stephennacion06/power-theft-detection/3D File/Rendered/Iso_prototype.jpg

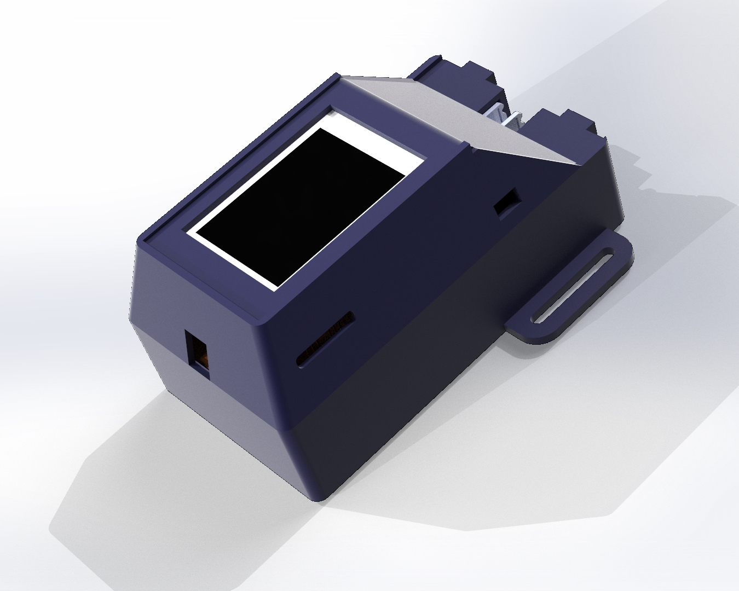
3D File/Rendered/Iso_prototype.jpg
