stephennacion06/power-theft-detection/3D File/Rendered/iso_back.jpg

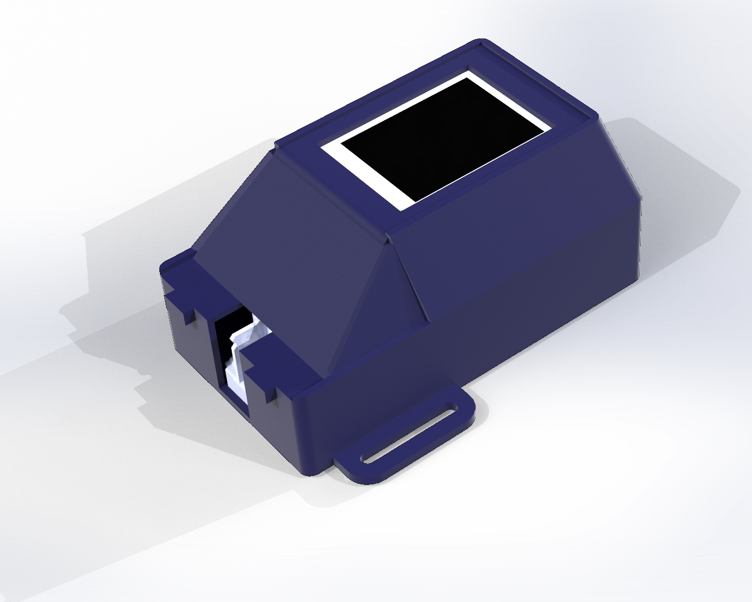
3D File/Rendered/iso_back.jpg
