stephennacion06/power-theft-detection/README.md

# power-theft-detection
Official Repository for Power Theft Detection System Project
