stephennacion06/power-theft-detection/3D File/3D printing/version_main_chassis_hours.PNG

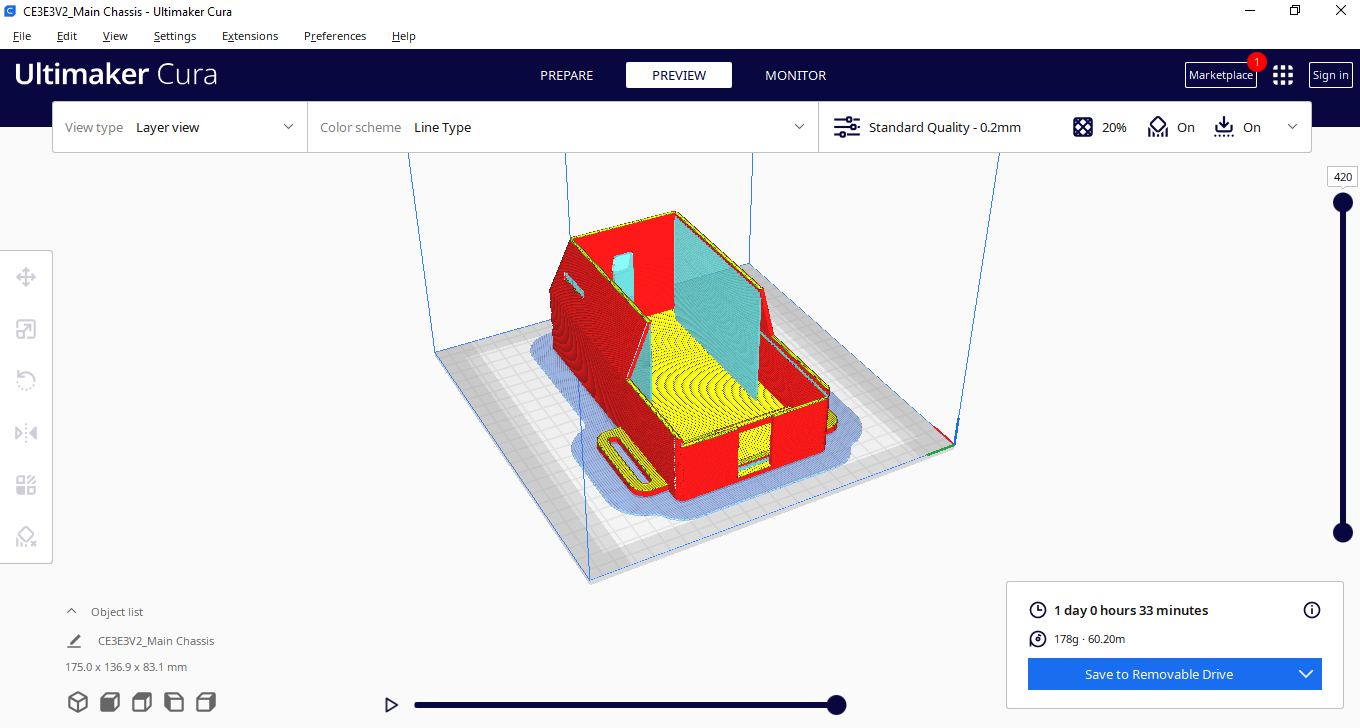
3D File/3D printing/version_main_chassis_hours.PNG
