stephennacion06/power-theft-detection/3D File/Rendered/glass_iso.jpg

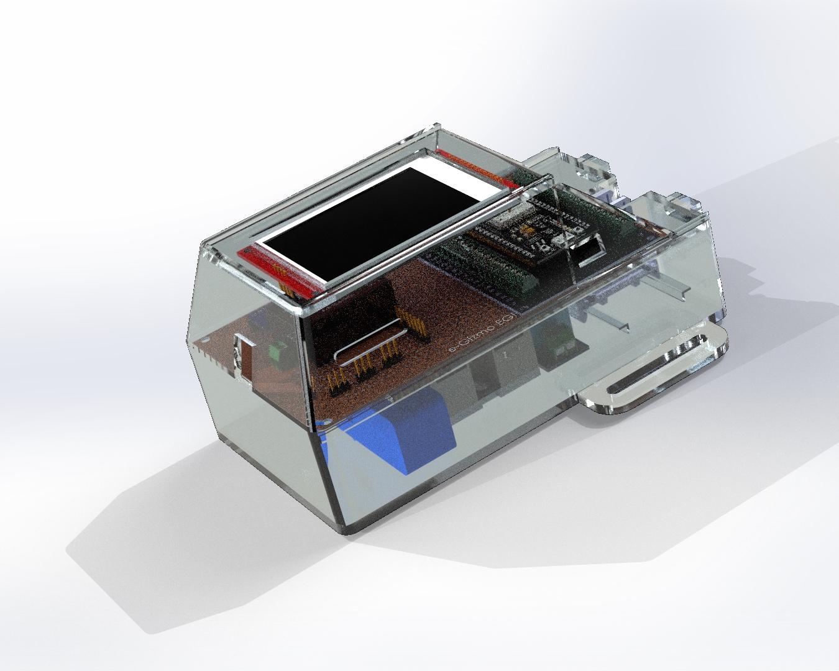
3D File/Rendered/glass_iso.jpg
