stephennacion06/power-theft-detection/3D File/Rendered/glass_rendered_back.jpg

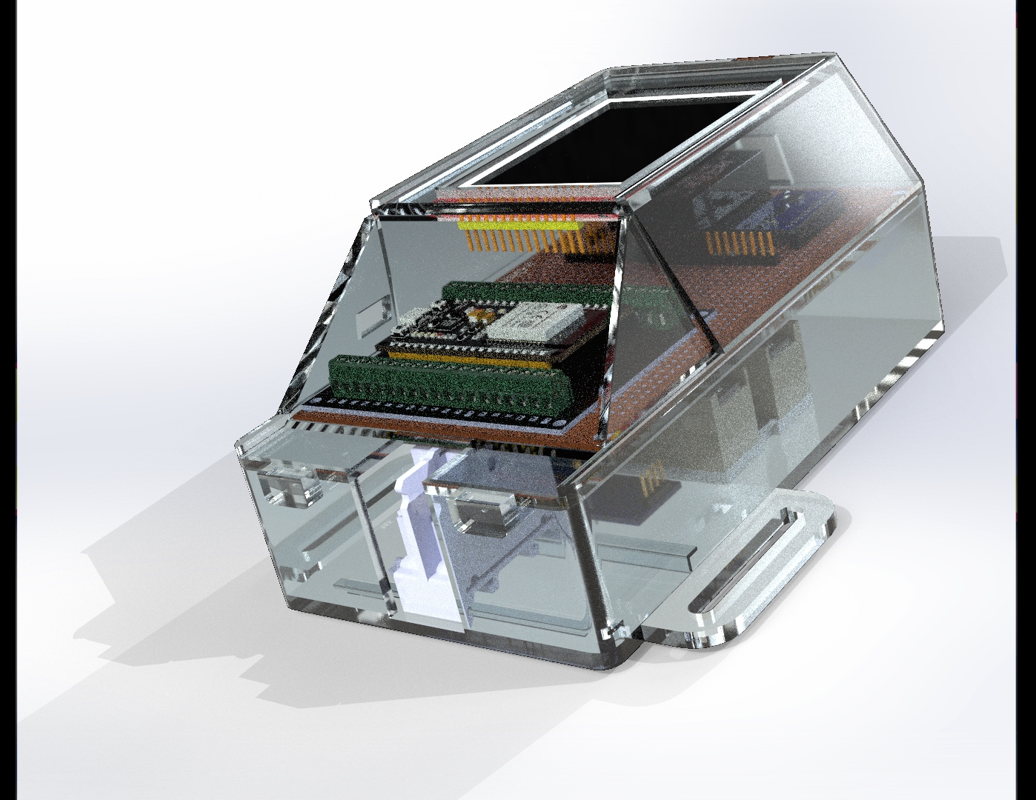
3D File/Rendered/glass_rendered_back.jpg
