stephennacion06/power-theft-detection/Documents/Design Docs/BoM.PNG

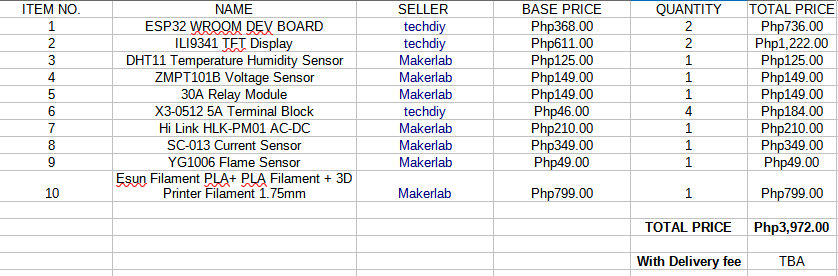
Documents/Design Docs/BoM.PNG
