stephennacion06/power-theft-detection/Documents/Design Docs/flow_chart_diagram.png

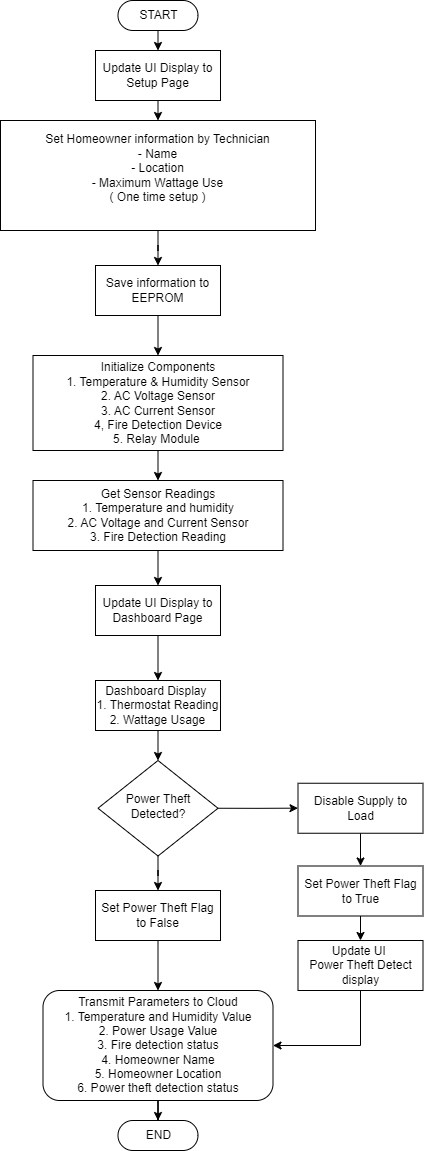
Documents/Design Docs/flow_chart_diagram.png
