stephennacion06/power-theft-detection/Documents/Design Docs/system_architecture_draft.png

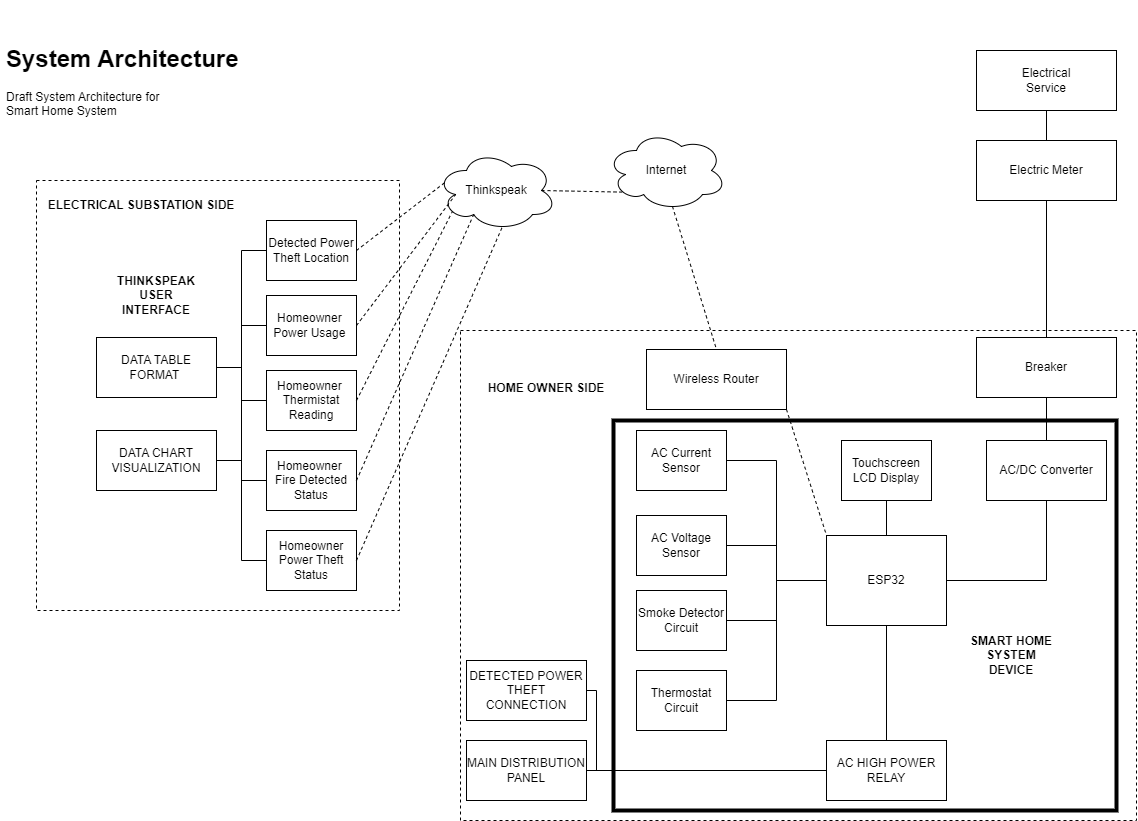
Documents/Design Docs/system_architecture_draft.png
