stephennacion06/power-theft-detection/Documents/References/design_button_1.PNG

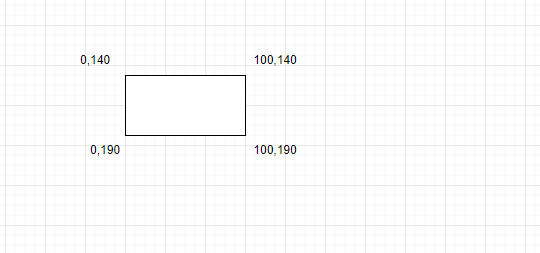
Documents/References/design_button_1.PNG
