stephennacion06/power-theft-detection/Documents/Design Docs/bill_of_materials.xlsx

ITEM NO. | NAME | SELLER | BASE PRICE | QUANTITY | TOTAL PRICE
1 | ESP32 WROOM DEV BOARD | techdiy (https://shopee.ph/38Pins-ESP32S-ESP32-2.4GHz-Dual-Core-WLAN-WiFi-Bluetooth-Microcontroller-ESP-WROOM-32-Chip-with-Breakout-Board-for-Arduino-i.306592453.21062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) | Php 368.00 | 1 | Php 368.00
2 | ILI9341 TFT Display | techdiy (https://shopee.ph/SPI-Serial-Port-Seriesctouch-2.2-2.4-2.8-3.2-3.5-4.0-Inch-TFT-LCD-Screen-Module-for-Stm32-Development-Board-i.306592453.22200907097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) | Php 611.00 | 1 | Php 611.00
3 | ZMPT101B Voltage Sensor | Makerlab (https://shopee.ph/AC-Voltage-Sensor-Module-ZMPT101B-i.18252381.6200885788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) | Php 149.00 | 1 | Php 149.00
4 | 30A Relay Module | Makerlab (https://shopee.ph/Taiwan-SSR-40DA-SSR-60DA-SSR-100DA-SSR-Solid-State-Relay-Module-i.18252381.190150070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) | Php 409.00 | 1 | Php 409.00
5 | X3-0512 5A Terminal Block | techdiy (https://shopee.ph/X3-2012-Nylon-Plastic-Terminal-Block-0512-1012-3012-6012-Connector-Copper-12-bit-20A-i.306592453.18611494771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) | Php 46.00 | 4 | Php 184.00
6 | Hi Link HLK-PM01 AC-DC | Makerlab (https://shopee.ph/Hi-Link-HLK-PM01-AC-DC-220V-to-5V-Step-down-Power-Supply-Module-i.18252381.1885503201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) | Php 210.00 | 1 | Php 210.00
7 | SC-013 Current Sensor | Makerlab (https://shopee.ph/Non-invasive-AC-Current-Sensor-30A-100A-SCT-013-030-i.18252381.242334790) | Php 349.00 | 1 | Php 349.00
8 | YG1006 Flame Sensor | Makerlab (https://shopee.ph/Flame-Sensor-Module-for-Arduino-i.18252381.314229553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) | Php 49.00 | 1 | Php 49.00
9 | Esun Filament PLA+ PLA Filament + 3D Printer Filament 1.75mm | Makerlab (https://shopee.ph/Esun-Filament-PLA-PLA-Filament-3D-Printer-Filament-1.75mm-i.18252381.1089934382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) | Php 799.00 | 1 | Php 799.00
10 | KY-021 Mini Dry Reed Switch Pipe Module | Makerlab (https://shopee.ph/KY-021-Mini-Dry-Reed-Switch-Pipe-Module-i.18252381.21906994555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) | Php 29.00 | 1 | Php 29.00
11 | PIR Motion Sensor SR501 HC-SR501 Module for Arduino Raspberry Pi | Makerlab (https://shopee.ph/PIR-Motion-Sensor-SR501-HC-SR501-Module-for-Arduino-Raspberry-Pi-i.18252381.190149793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) | Php 79.00 | 1 | Php 79.00
 |  |  |  | TOTAL PRICE | Php 3236.00
 |  |  |  | With Delivery fee | TBA
