stephennacion06/power-theft-detection/Documents/Design Docs/software_components.png

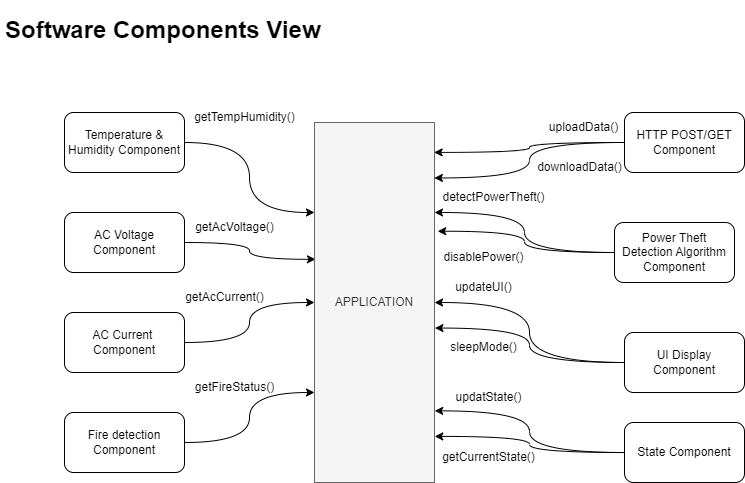
Documents/Design Docs/software_components.png
