stephennacion06/power-theft-detection/3D File/3D printing/Cover Main.STL

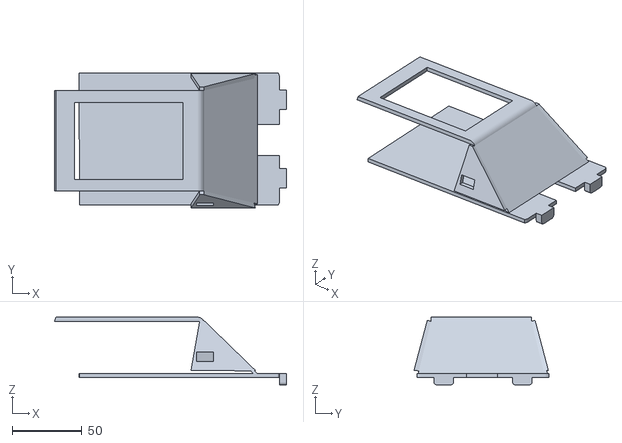
[picture p21: CAD file, 2023-07-22]
3D File/3D printing/Cover Main.STL
166.1 x 96.7 x 48.5
