stephennacion06/power-theft-detection/3D File/3D printing/Main Chassis.STL

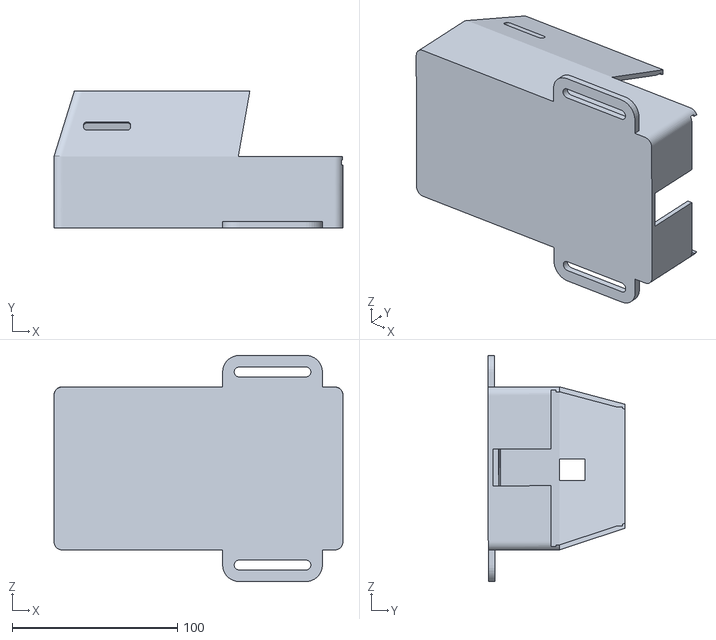
[picture p22: CAD file, 2023-07-22]
3D File/3D printing/Main Chassis.STL
175.0 x 83.2 x 136.9
