stephennacion06/power-theft-detection/3D File/Components/ky-021_door_sensor/male_header_angled.SLDASM

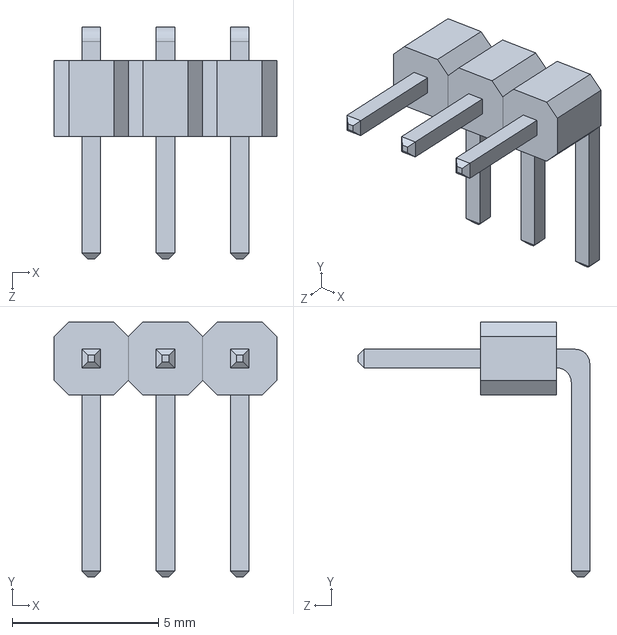
[picture p23: CAD file, 2023-07-19]
3D File/Components/ky-021_door_sensor/male_header_angled.SLDASM
7.62 x 8.73 x 7.94 mm
HeaderMalePart x 3
