stephennacion06/power-theft-detection/3D File/Components/pir-hc-sr-501/pir_hc_sr-501_sensor.SLDASM

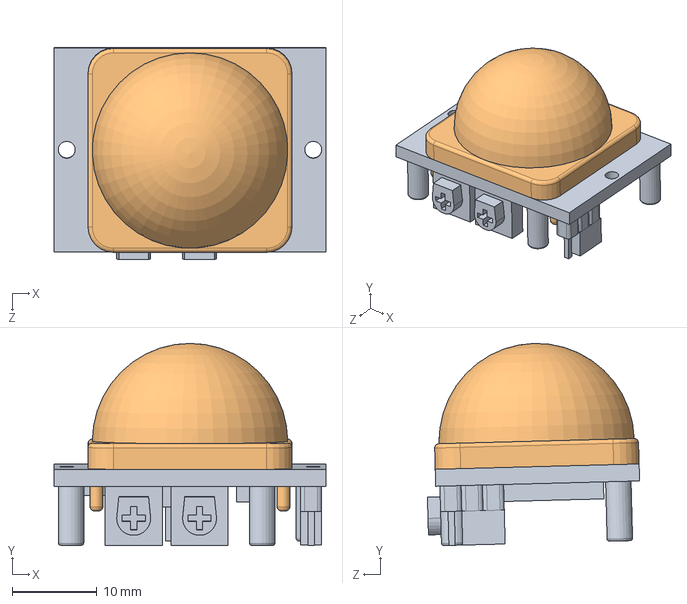
[picture p24: CAD file, 2023-07-19]
3D File/Components/pir-hc-sr-501/pir_hc_sr-501_sensor.SLDASM
32.0 x 23.8 x 25.0 mm
sensor
lens
