stephennacion06/power-theft-detection/3D File/Components/ky-021_door_sensor/ky-021.SLDASM

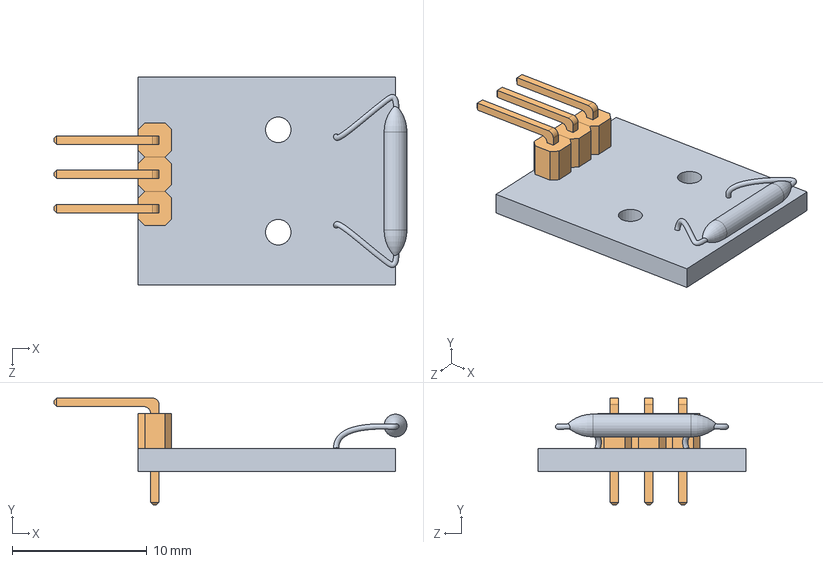
[picture p25: CAD file, 2023-07-19]
3D File/Components/ky-021_door_sensor/ky-021.SLDASM
26.2 x 7.94 x 15.4 mm
reed_switch_body
HeaderMalePart x 3
