stephennacion06/power-theft-detection/3D File/Components/current_sensor_sc103.SLDASM

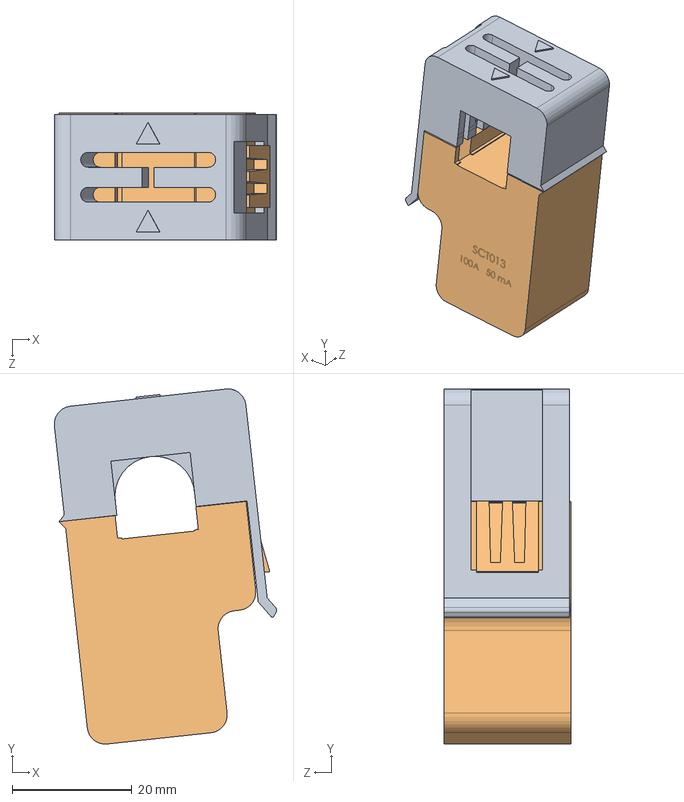
[picture p26: CAD file, 2023-07-19]
3D File/Components/current_sensor_sc103.SLDASM
37.1 x 59.3 x 21.3 mm
sensor part 1
sEnsor 2SLDPRT
