stephennacion06/power-theft-detection/3D File/Components/3pinheader_male.SLDASM

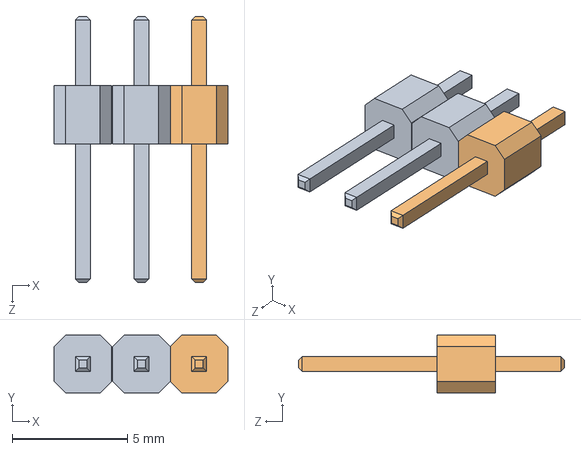
[picture p27: CAD file, 2023-07-19]
3D File/Components/3pinheader_male.SLDASM
7.54 x 2.50 x 11.5 mm
2pins.step
1pins.step
