stephennacion06/power-theft-detection/3D File/Components/ky-021_door_sensor/reed_switch_body.SLDPRT

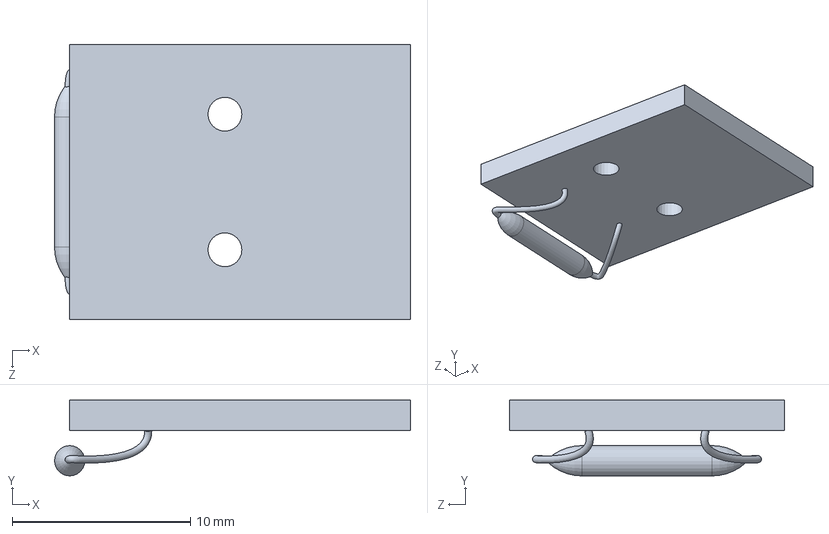
[picture p28: CAD file, 2023-07-19]
3D File/Components/ky-021_door_sensor/reed_switch_body.SLDPRT
19.9 x 4.25 x 15.4 mm
