stephennacion06/power-theft-detection/3D File/Components/pir-hc-sr-501/lens.STEP

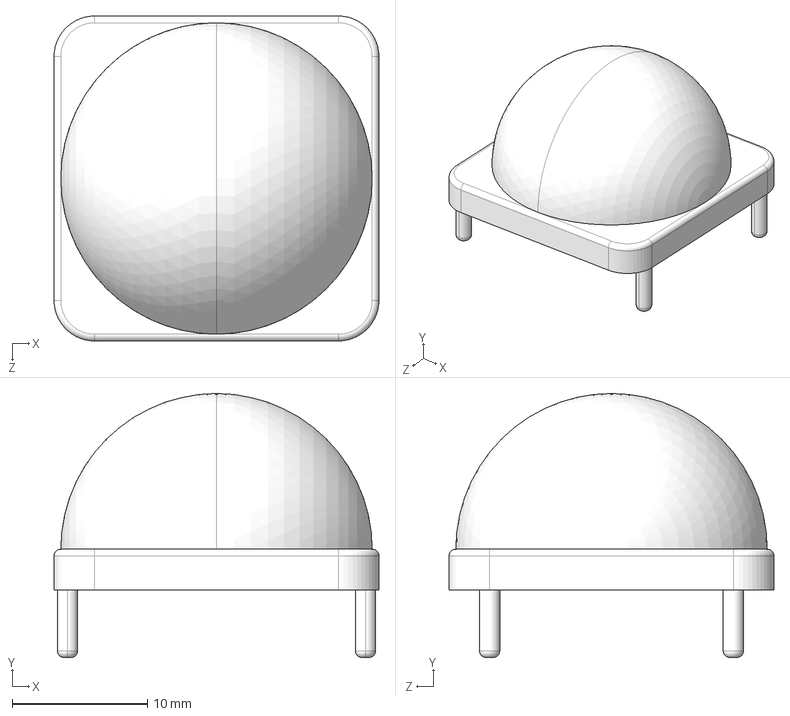
[picture p29: CAD file, 2023-07-19]
3D File/Components/pir-hc-sr-501/lens.STEP
24.0 x 19.5 x 24.0 mm
