stephennacion06/power-theft-detection/3D File/din-rail-aluminum-35-mm-wide-7-mm-height-4-mm-wide-and-8-mm-length-slots-100-mm-length-1.snapshot.1/DIN Rail, Aluminum, 35 mm Wide, 7 mm Height, 4 mm Wide and 8 mm Length Slots, 100 mm Length.SLDPRT

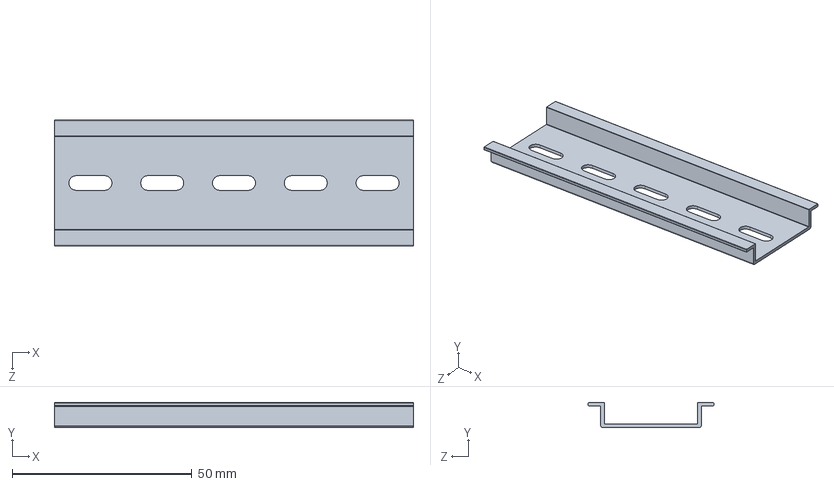
[picture p30: CAD file, 2023-07-19]
3D File/din-rail-aluminum-35-mm-wide-7-mm-height-4-mm-wide-and-8-mm-length-slots-100-mm-length-1.snapshot.1/DIN Rail, Aluminum, 35 mm Wide, 7 mm Height, 4 mm Wide and 8 mm Length Slots, 100 mm Length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
100.0 x 7.00 x 35.0 mm
