stephennacion06/power-theft-detection/3D File/Components/BNH15LW_converted.SLDPRT

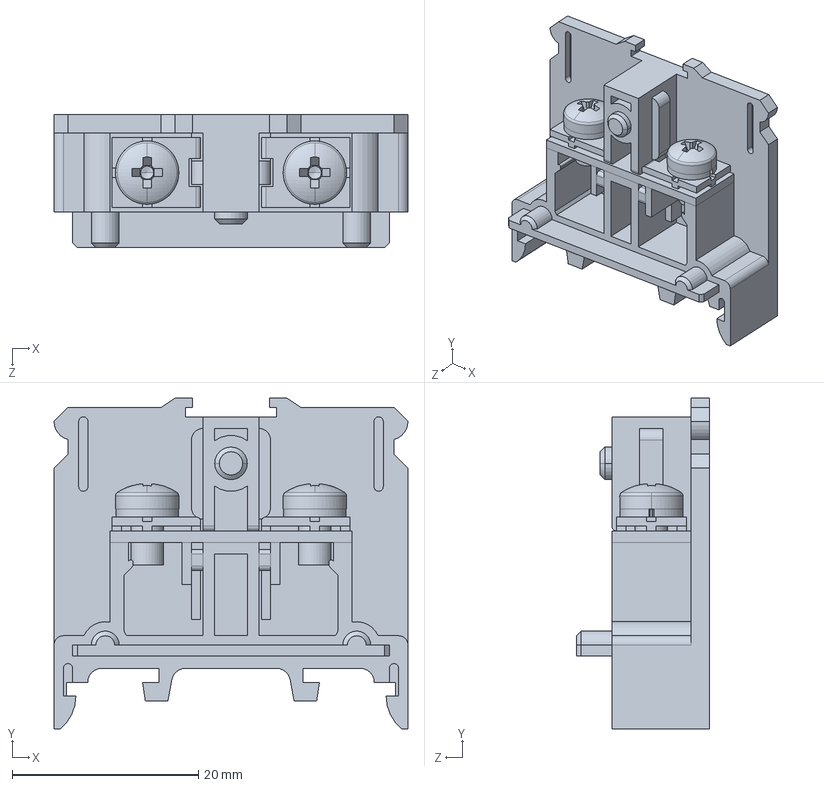
[picture p31: CAD file, 2023-07-22]
3D File/Components/BNH15LW_converted.SLDPRT
38.0 x 35.5 x 14.3 mm
