stephennacion06/power-theft-detection/3D File/Components/pir-hc-sr-501/sensor.STEP

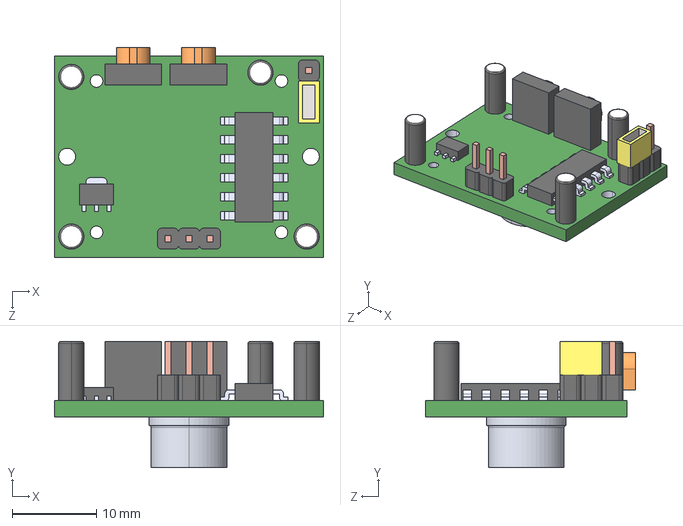
[picture p32: CAD file, 2023-07-19]
3D File/Components/pir-hc-sr-501/sensor.STEP
32.0 x 15.0 x 25.0 mm
