stephennacion06/power-theft-detection/3D File/Components/ky-021_door_sensor/HeaderMalePart.SLDPRT

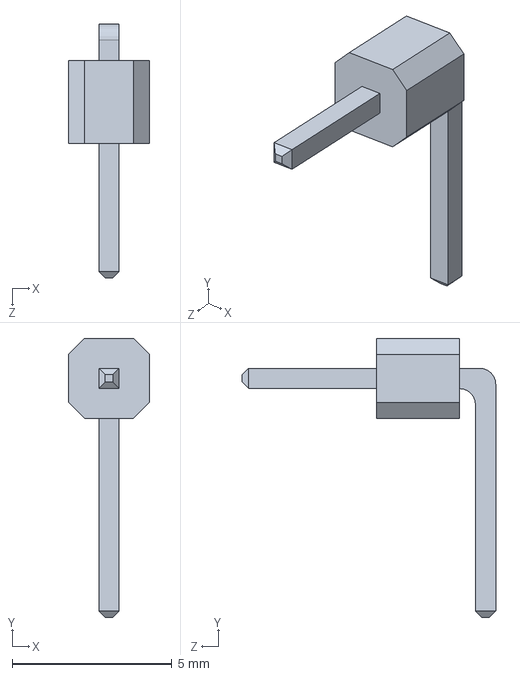
[picture p33: CAD file, 2023-07-19]
3D File/Components/ky-021_door_sensor/HeaderMalePart.SLDPRT
2.54 x 8.73 x 7.94 mm
