stephennacion06/power-theft-detection/3D File/Components/door_sensor_magnet.SLDPRT

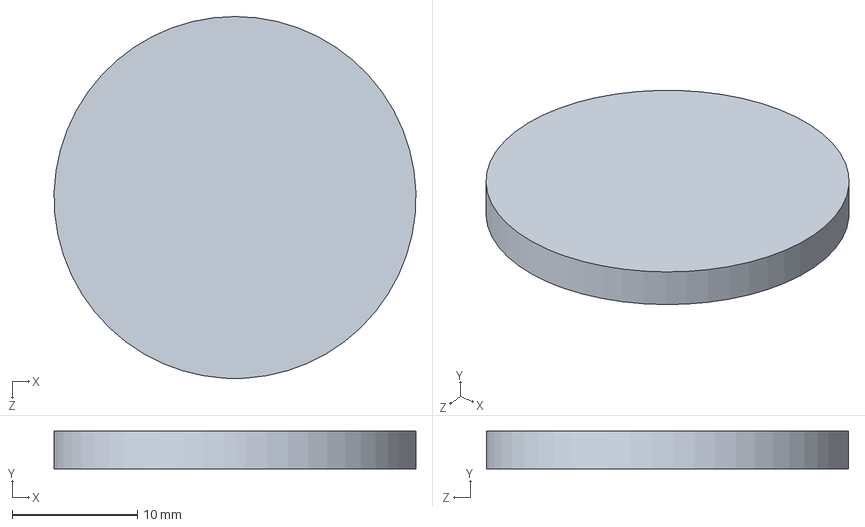
[picture p34: CAD file, 2023-07-19]
3D File/Components/door_sensor_magnet.SLDPRT
28.9 x 3.00 x 28.9 mm
