stephennacion06/power-theft-detection/3D File/Components/sEnsor 2SLDPRT.SLDPRT

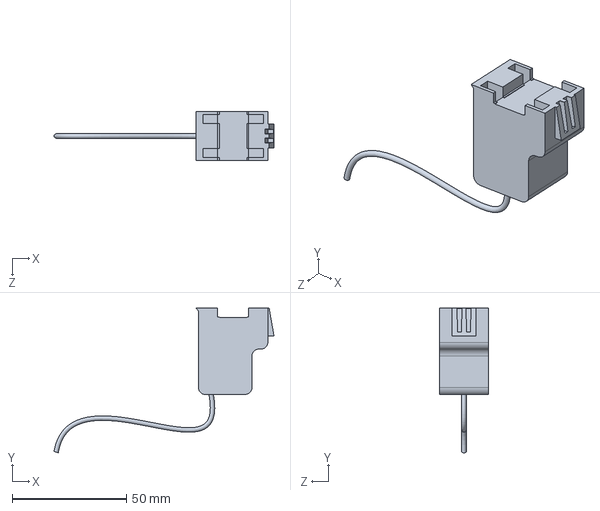
[picture p35: CAD file, 2023-07-19]
3D File/Components/sEnsor 2SLDPRT.SLDPRT
96.4 x 63.4 x 21.3 mm
