stephennacion06/power-theft-detection/3D File/Components/2pins.step

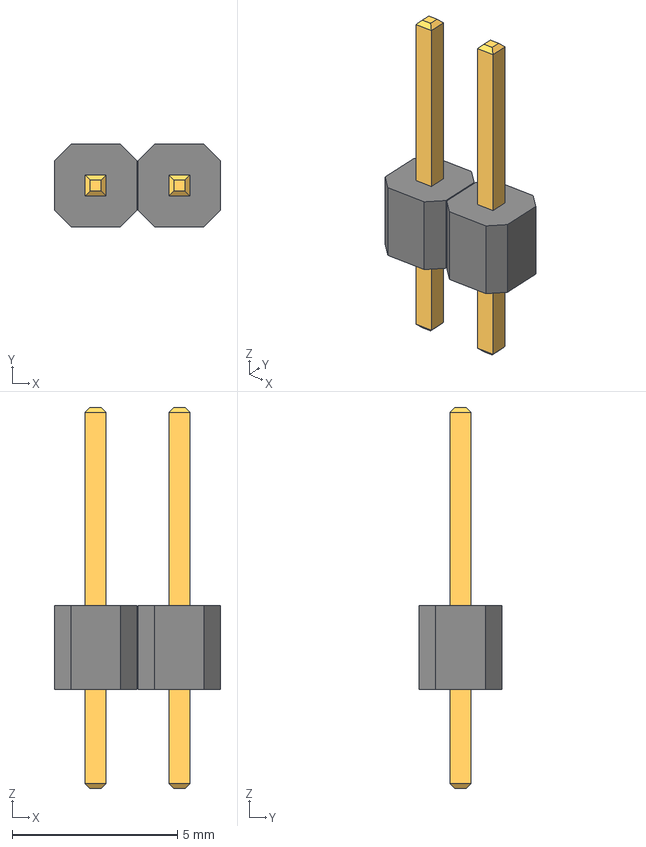
[picture p36: CAD file, 2023-07-19]
3D File/Components/2pins.step
5.04 x 2.50 x 11.5 mm
