stephennacion06/power-theft-detection/3D File/Components/voltage_sensor_zmp101b.step

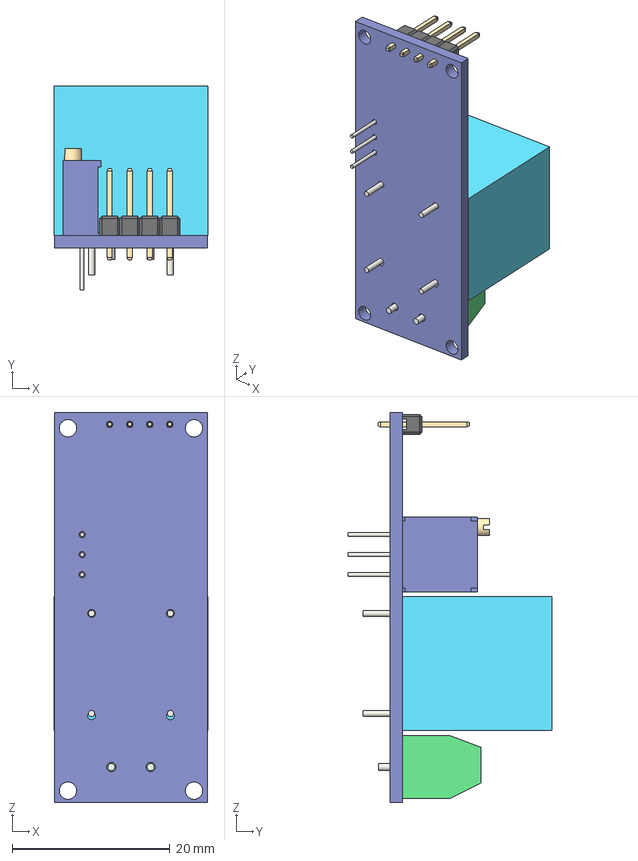
[picture p37: CAD file, 2023-07-19]
3D File/Components/voltage_sensor_zmp101b.step
19.5 x 25.9 x 49.5 mm
VTsensor_Board
ZMPT101B
3296W
Header_Male_1x4x11.6
