stephennacion06/power-theft-detection/3D File/Components/8pins.step

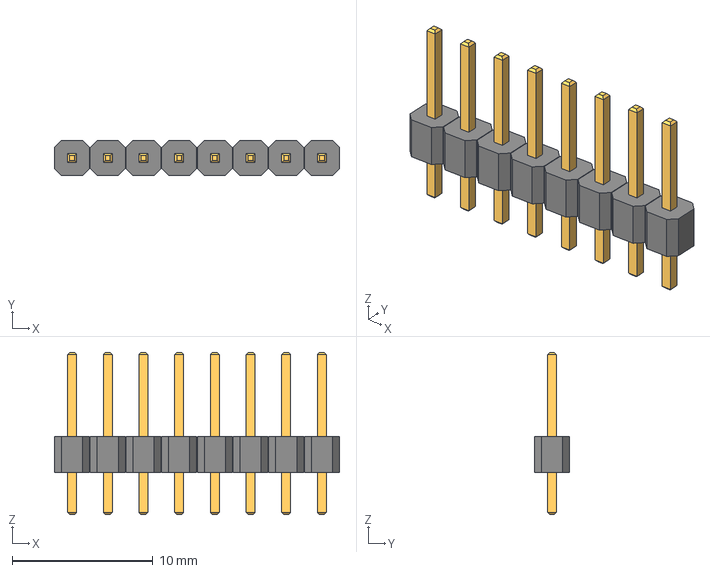
[picture p38: CAD file, 2023-07-19]
3D File/Components/8pins.step
20.3 x 2.50 x 11.5 mm
