stephennacion06/power-theft-detection/3D File/Components/1pins.step

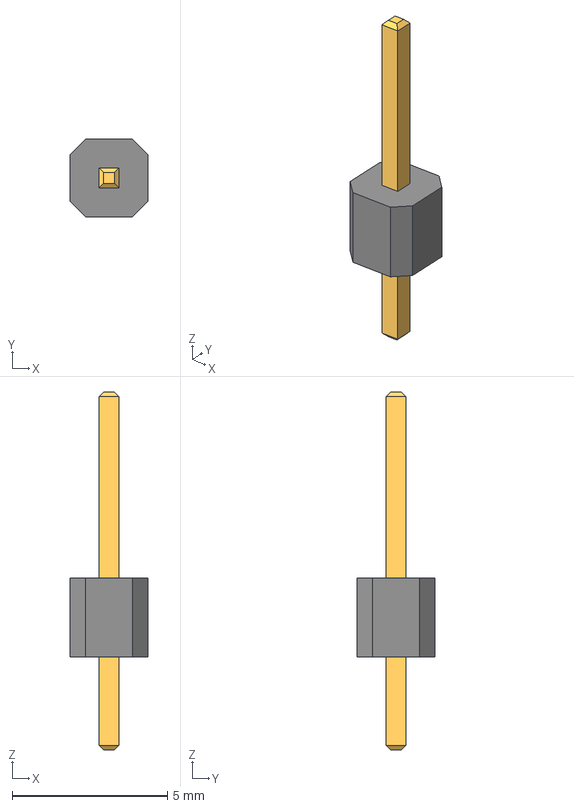
[picture p39: CAD file, 2023-07-19]
3D File/Components/1pins.step
2.50 x 2.50 x 11.5 mm
