stephennacion06/power-theft-detection/3D File/Components/Flame Sensor.SLDPRT

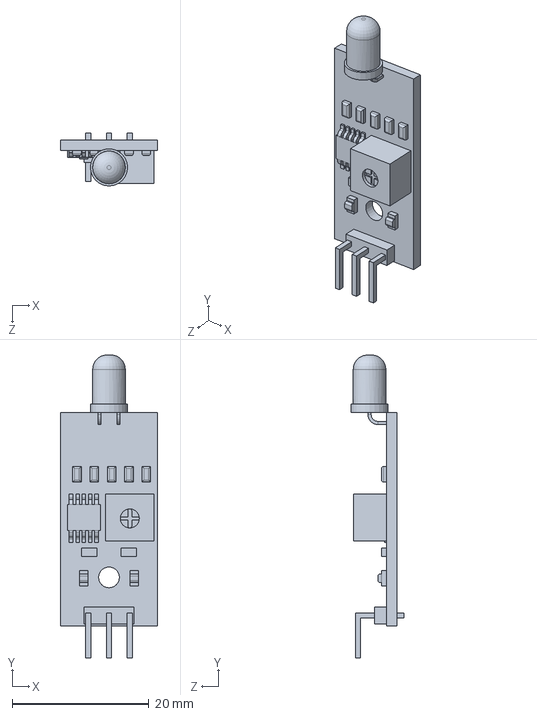
[picture p40: CAD file, 2023-07-19]
3D File/Components/Flame Sensor.SLDPRT
14.2 x 44.4 x 7.77 mm
