stephennacion06/power-theft-detection/3D File/Components/10-Pin Header - Female - 2.54mm.step

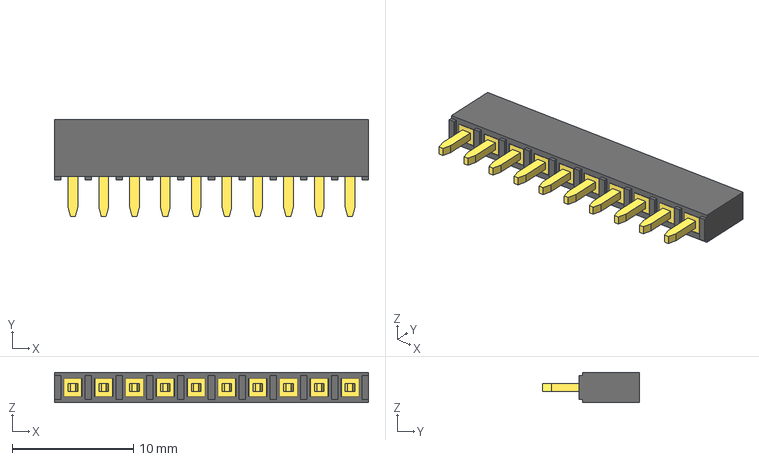
[picture p41: CAD file, 2023-07-19]
3D File/Components/10-Pin Header - Female - 2.54mm.step
25.9 x 8.00 x 2.50 mm
