stephennacion06/power-theft-detection/3D File/Components/ssr_relay.SLDPRT

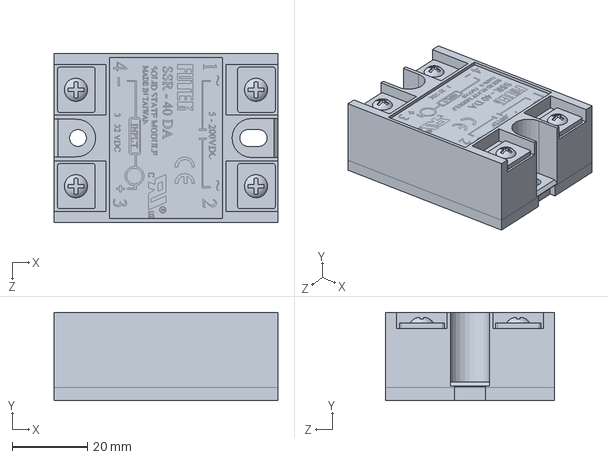
[picture p42: CAD file, 2023-07-19]
3D File/Components/ssr_relay.SLDPRT
59.7 x 23.5 x 45.0 mm
