stephennacion06/power-theft-detection/3D File/Components/sensor part 1.SLDPRT

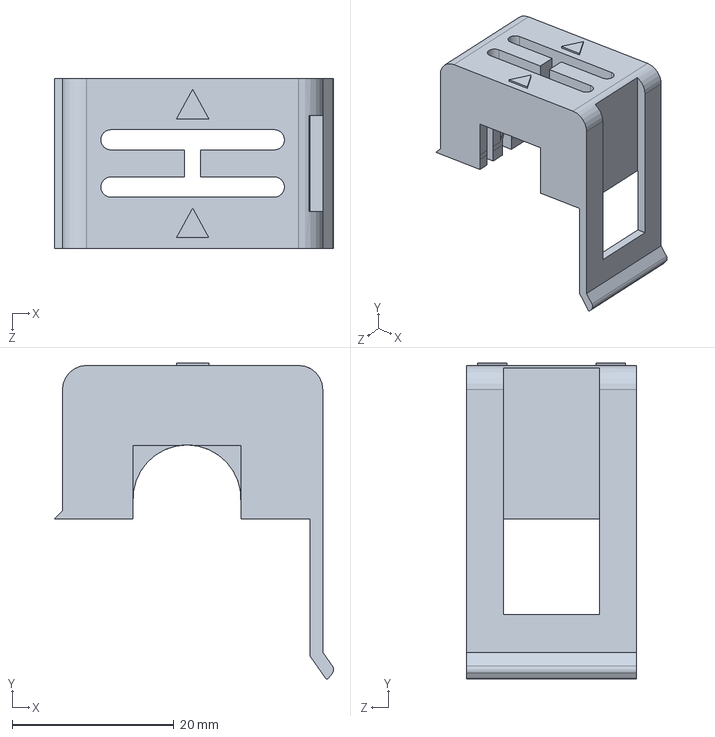
[picture p43: CAD file, 2023-07-19]
3D File/Components/sensor part 1.SLDPRT
34.5 x 39.1 x 21.0 mm
