stephennacion06/power-theft-detection/3D File/Components/16Bit I2C ADC+PGA - ADS1115.stp

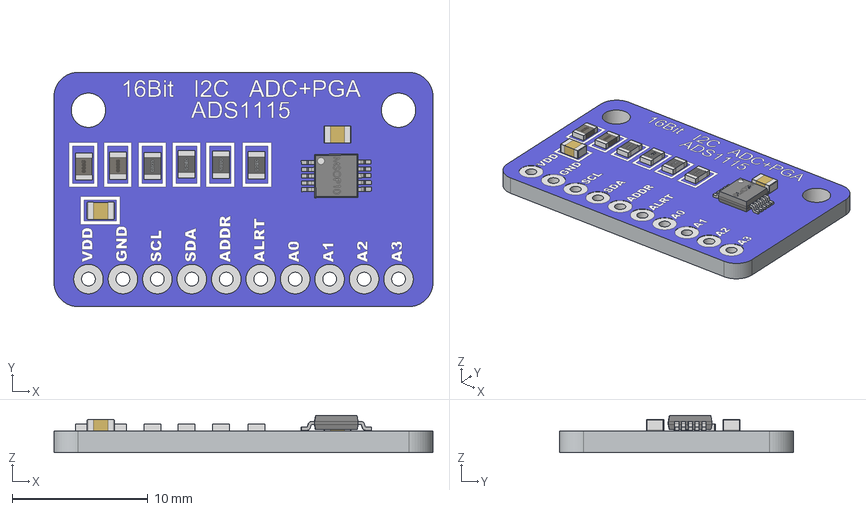
[picture p44: CAD file, 2023-07-17]
3D File/Components/16Bit I2C ADC+PGA - ADS1115.stp
27.9 x 17.3 x 2.74 mm
ADS1115
0805 Capacitor x 2
0805 Inductor x 2
0805 Resistor x 4
MSOP10
