stephennacion06/power-theft-detection/3D File/Components/tft_spi_320x240.step

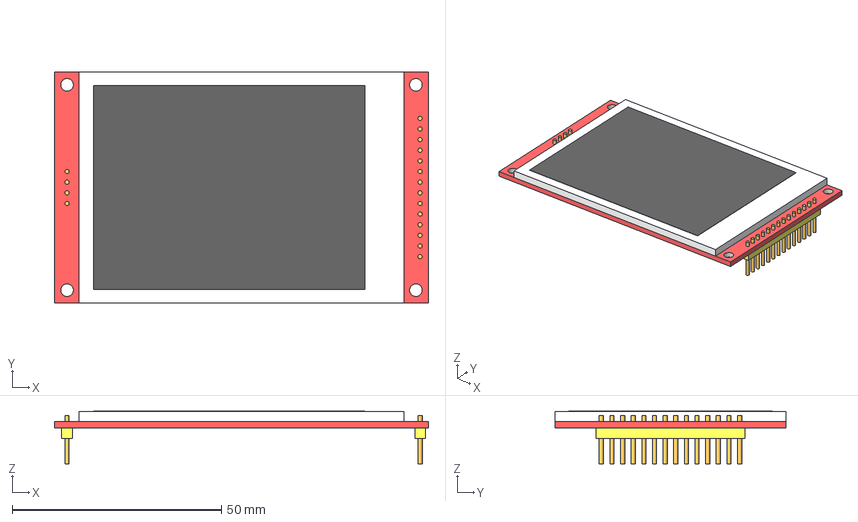
[picture p45: CAD file, 2023-07-17]
3D File/Components/tft_spi_320x240.step
89.3 x 55.0 x 12.5 mm
