stephennacion06/power-theft-detection/3D File/Components/19-Pin Header - Female - 2.54mm.step

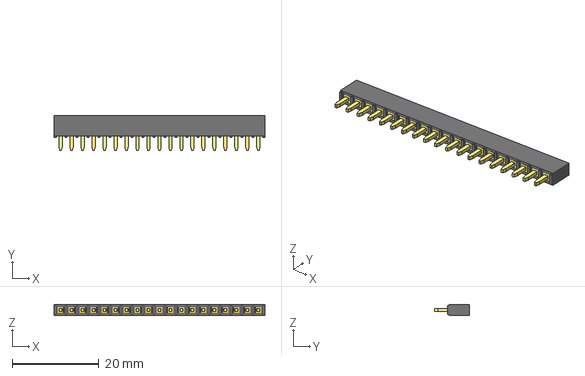
[picture p46: CAD file, 2023-07-17]
3D File/Components/19-Pin Header - Female - 2.54mm.step
48.8 x 8.00 x 2.50 mm
