stephennacion06/power-theft-detection/3D File/Components/esp32shield.SLDPRT

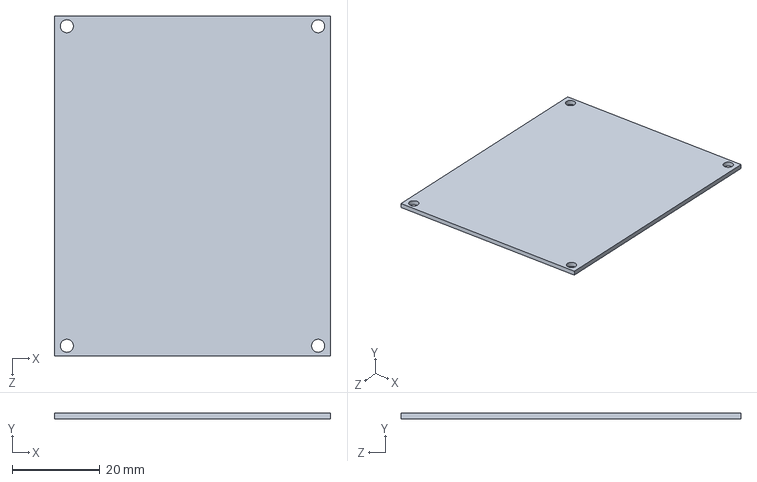
[picture p47: CAD file, 2023-07-17]
3D File/Components/esp32shield.SLDPRT
63.1 x 1.30 x 77.7 mm
