stephennacion06/power-theft-detection/3D File/Components/Hi-link 5v rectifier module.stp

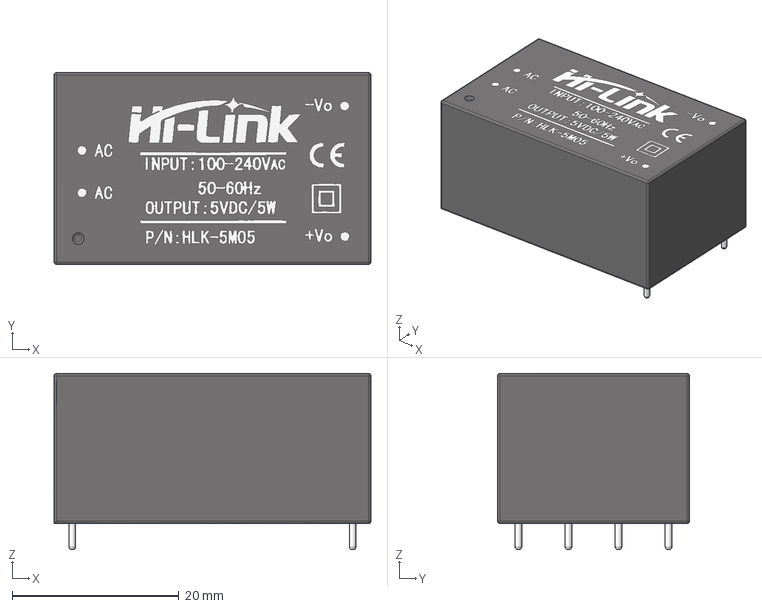
[picture p48: CAD file, 2023-07-17]
3D File/Components/Hi-link 5v rectifier module.stp
38.0 x 23.0 x 21.1 mm
