stephennacion06/power-theft-detection/3D File/Components/egizmo_universal_pcb.SLDPRT

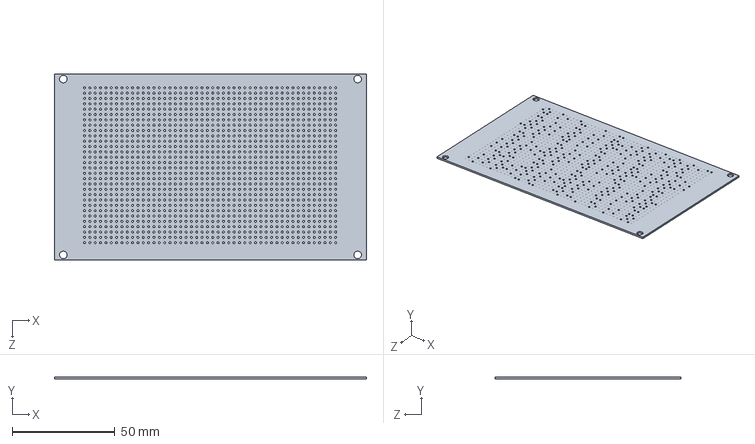
[picture p49: CAD file, 2023-07-17]
3D File/Components/egizmo_universal_pcb.SLDPRT
151.8 x 1.10 x 90.7 mm
