stephennacion06/power-theft-detection/(list of files, cad)

Other CAD files:
3D File/Components/Main Chassis.SLDPRT
3D File/Components/Chassis Cover.SLDPRT
3D File/Components/pir-hc-sr-501/sensor board.STEP
3D File/Components/pcb_screw_terminal_block_15pins.step
3D File/Components/pcb_screw_terminal_block_2_pins.STEP
3D File/Components/pcb_screw_terminal_block_4pins.step
3D File/Components/pir-hc-sr-501/lens.SLDPRT
3D File/Components/pir-hc-sr-501/sensor.SLDPRT
