stephennacion06/power-theft-detection/Documents/Design Docs/wiring_diagram.jpg

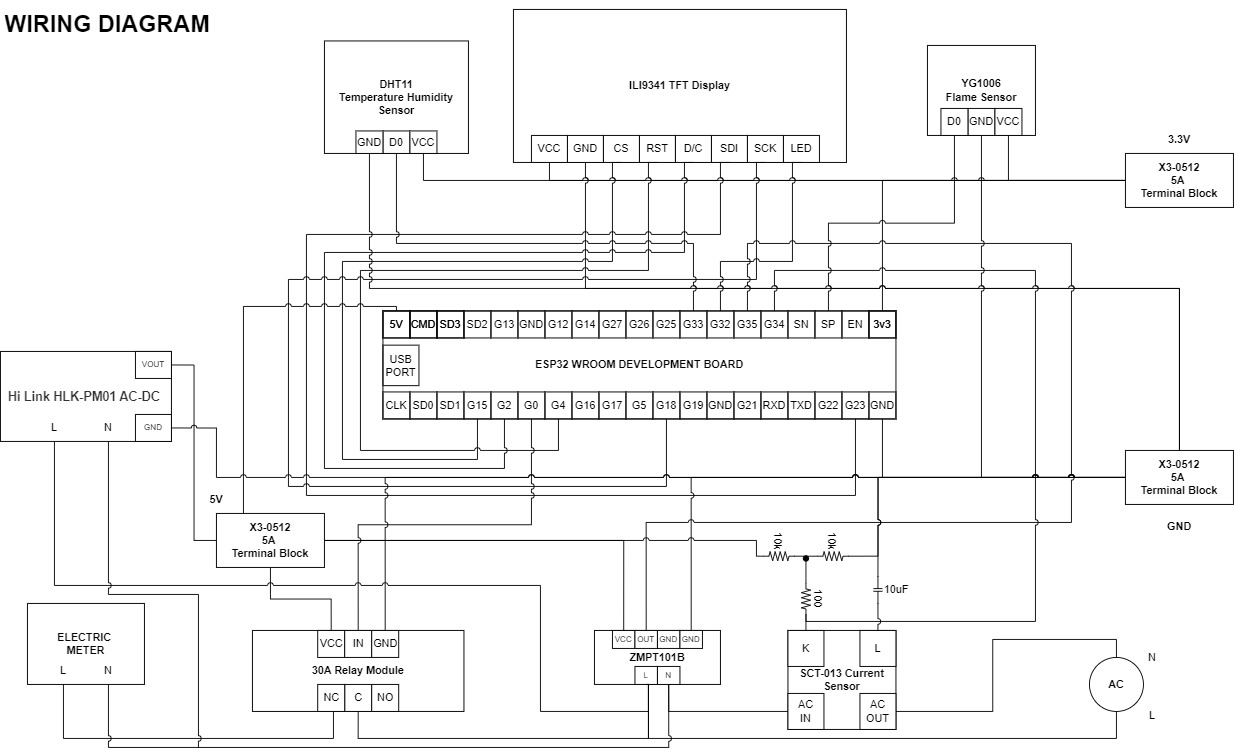
Documents/Design Docs/wiring_diagram.jpg
