stephennacion06/power-theft-detection/Documents/Design Docs/wiring_diagramV4.jpg

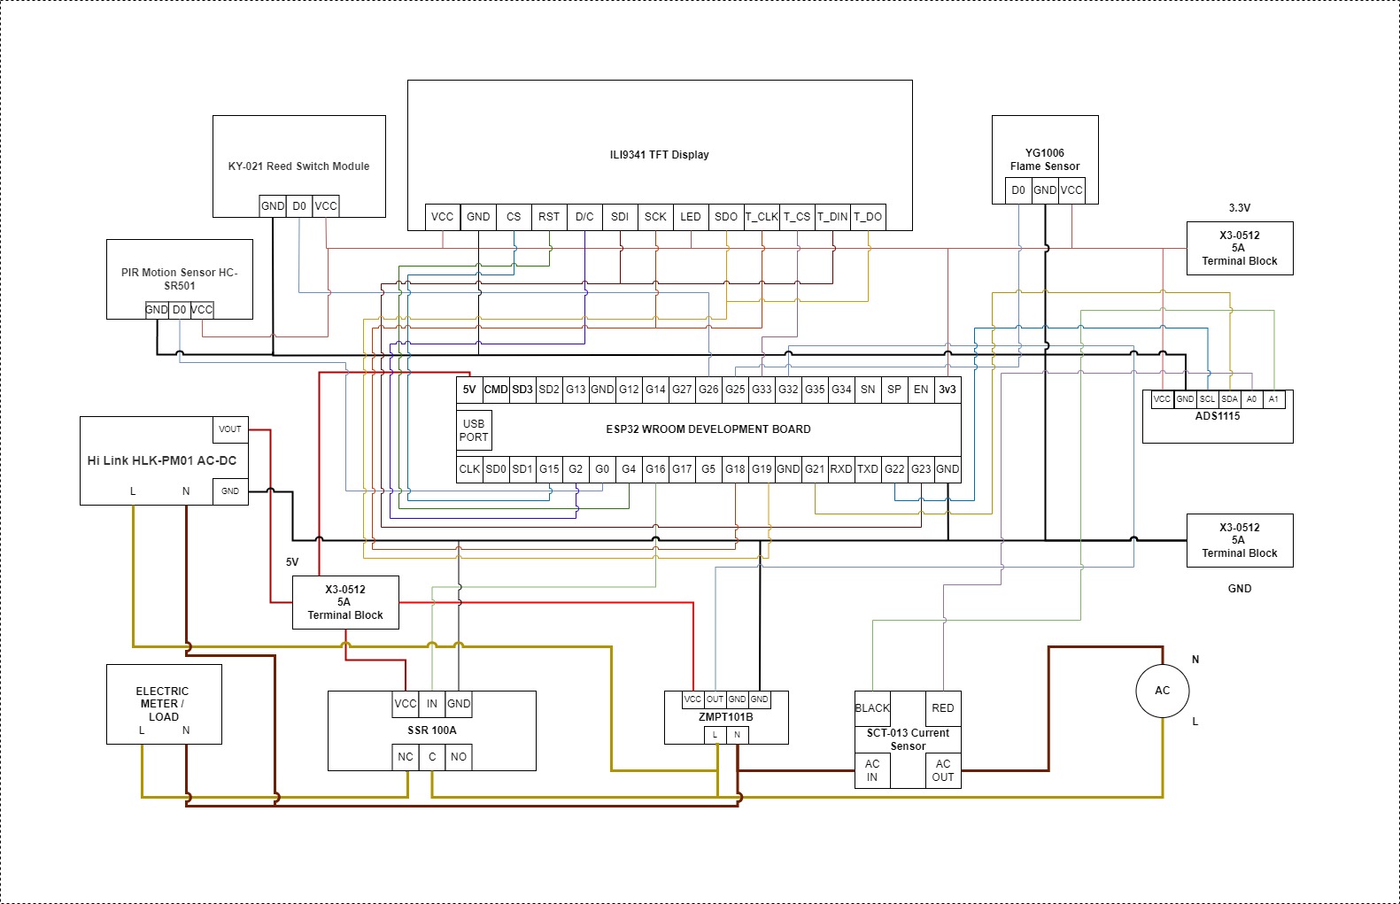
Documents/Design Docs/wiring_diagramV4.jpg
