stephennacion06/power-theft-detection/Documents/Design Docs/flow_chart_diagram.pdf

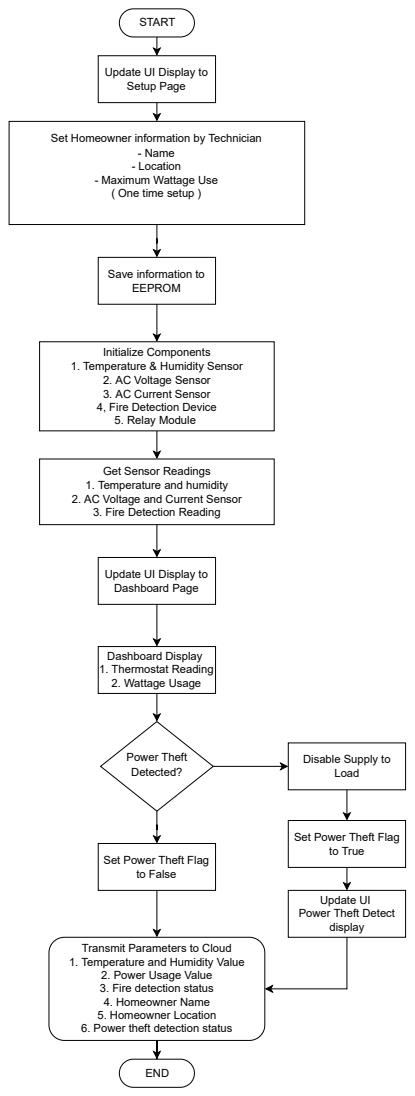
[picture p53: page 1]
START; END; Power Theft Detected?; Dashboard Display 1. Thermostat Reading 2. Wattage Usage

Update UI Display to
Setup Page

Set Homeowner information by Technician

- Name
- Location
- Maximum Wattage Use
( One time setup )

Save information to
EEPROM

Initialize Components
1. Temperature & Humidity Sensor
2. AC Voltage Sensor
3. AC Current Sensor
4, Fire Detection Device
5. Relay Module

Get Sensor Readings
1. Temperature and humidity
2. AC Voltage and Current Sensor
3. Fire Detection Reading

Dashboard Page

Disable Supply to
Load

Set Power Theft Flag
to True

to False

Update UI
Power Theft Detect
display

Transmit Parameters to Cloud
1. Temperature and Humidity Value
2. Power Usage Value
3. Fire detection status
4. Homeowner Name
5. Homeowner Location
6. Power theft detection status
