stephennacion06/power-theft-detection/Documents/Design Docs/flow_chart_diagram_v2.pdf

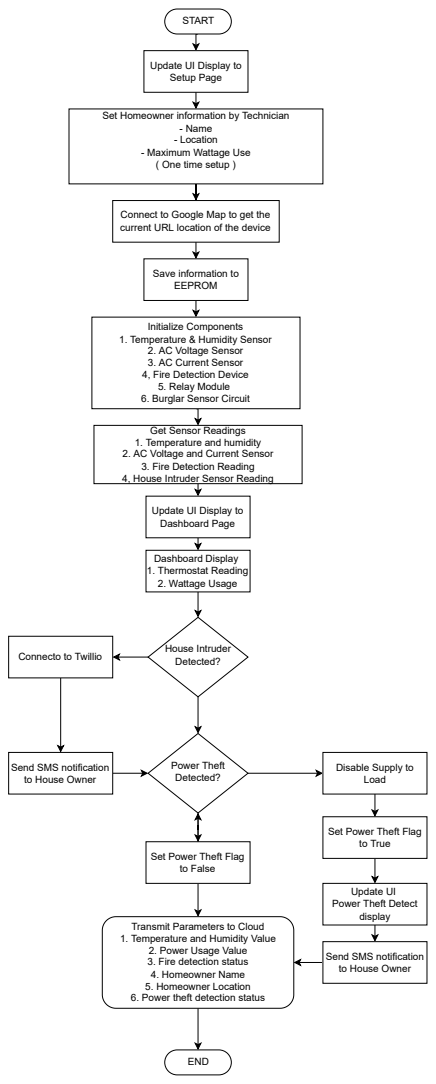
[picture p54: page 1]
START; END; Power Theft Detected?; Dashboard Display 1. Thermostat Reading 2. Wattage Usage; House Intruder

Update UI Display to
Setup Page

Set Homeowner information by Technician

- Name
- Location
- Maximum Wattage Use
( One time setup )

Connect to Google Map to get the
current URL location of the device

Save information to
EEPROM

Initialize Components
1. Temperature & Humidity Sensor
2. AC Voltage Sensor
3. AC Current Sensor
4, Fire Detection Device
5. Relay Module
6. Burglar Sensor Circuit

Get Sensor Readings
1. Temperature and humidity
2. AC Voltage and Current Sensor
3. Fire Detection Reading
4, House Intruder Sensor Reading

Dashboard Page

Detected? Connecto to Twillio

Send SMS notification
to House Owner

Disable Supply to
Load

Set Power Theft Flag
to True

to False

Update UI
Power Theft Detect
display

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
