stephennacion06/power-theft-detection/Documents/Design Docs/software_components.pdf

# Software Components View

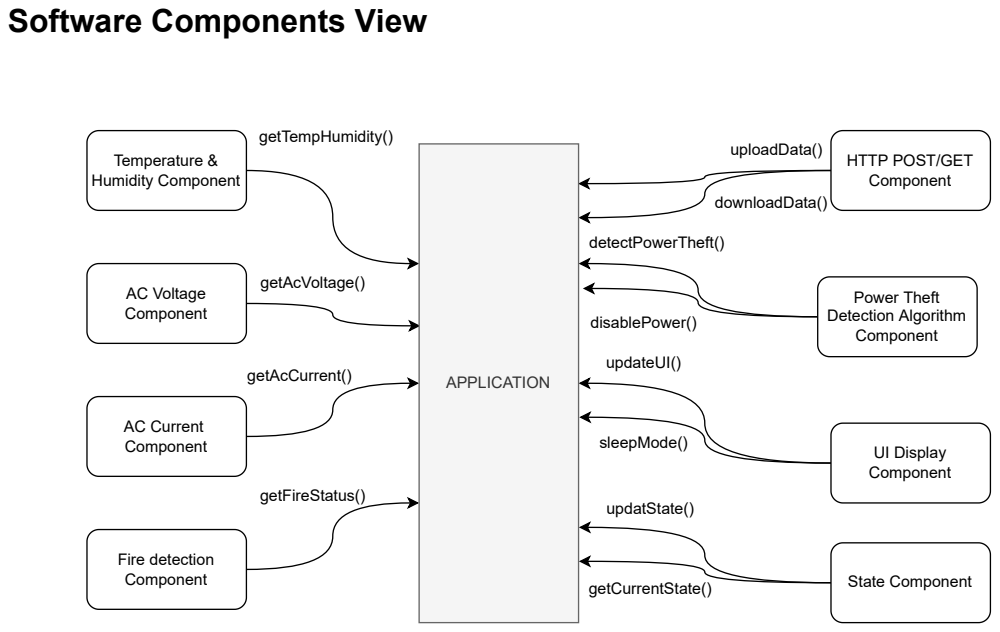
[picture p55: page 1]
Temperature & Humidity Component; AC Voltage Component; AC Current Component; Power Theft Detection Algorithm Component; UI Display Component; Fire detection Component; APPLICATION; getTempHumidity(); getAcVoltage(); getAcCurrent(); State Component; getFireStatus(); updateUI(); sleepMode(); detectPowerTheft(); disablePower(); uploadData(); downloadData(); getCurrentState(); updatState()

HTTP POST/GET
Component
