stephennacion06/power-theft-detection/Documents/Design Docs/system_architecture_draft.pdf

# System Architecture

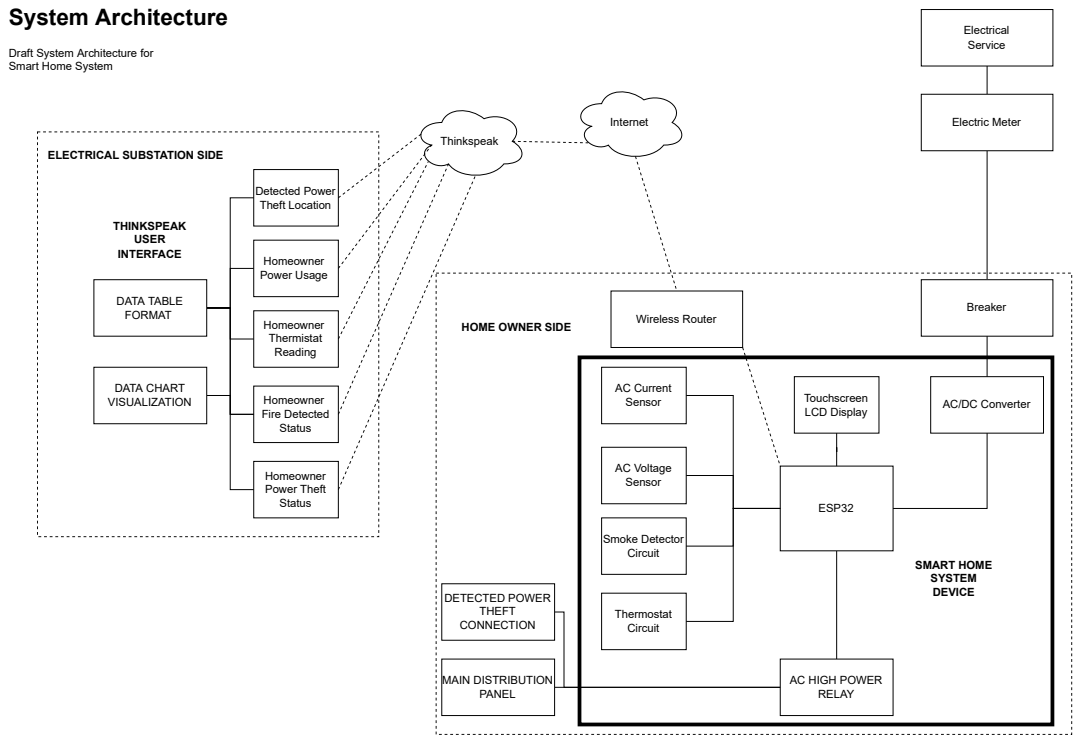
[picture p56: page 1]
Electrical Service; Electric Meter; Breaker; ESP32; AC Current Sensor; AC Voltage Sensor; Smoke Detector Circuit; Thermostat Circuit; Touchscreen LCD Display; MAIN DISTRIBUTION PANEL; DETECTED POWER THEFT CONNECTION; Wireless Router; Internet; SMART HOME SYSTEM DEVICE; Detected Power Theft Location; Homeowner Power Usage; Homeowner Thermistat Reading; Homeowner Fire Detected Status; Homeowner Power Theft Status; Thinkspeak; THINKSPEAK USER INTERFACE; DATA TABLE FORMAT; DATA CHART VISUALIZATION

Draft System Architecture for
Smart Home System

ELECTRICAL SUBSTATION SIDE

HOME OWNER SIDE

AC/DC Converter

AC HIGH POWER
RELAY
