stephennacion06/power-theft-detection/Documents/Design Docs/wiring_diagram.pdf

# WIRING DIAGRAM

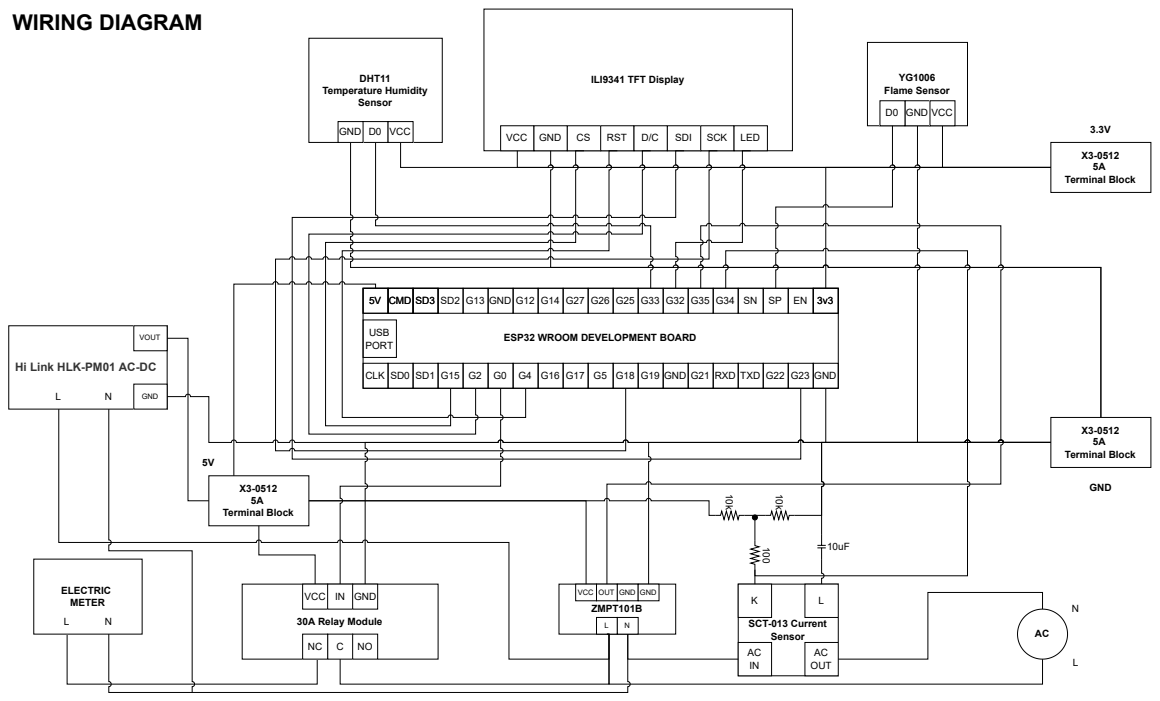
[picture p57: page 1]
CMD; GND; USB PORT; CLK; RXD; TXD; X3-0512 5A Terminal Block; ILI9341 TFT Display; SCT-013 Current; AC OUT; ZMPT101B; VCC; OUT; YG1006 Flame Sensor; DHT11 Temperature Humidity Sensor; 30A Relay Module; ELECTRIC METER; VOUT

D0 | GND | VCC

GND | D0 | VCC

VCC | GND | CS | RST | D/C | SDI | SCK | LED

ESP32 WROOM DEVELOPMENT BOARD

Hi Link HLK-PM01 AC-DC

NC | C | NO | Sensor
