stephennacion06/power-theft-detection/power-theft-detection/src/main.cpp

#include <Arduino.h>
#include "tft_display/ui_display.h"
#include "state_machine/statemachine.h"
#include "thingspeak/thingspeak_security.h"
#include "twilio_sms/twilio_sms.h"
#include <WiFiClientSecure.h>
#include <Adafruit_I2CDevice.h>
#include <EEPROM.h>
#include <WiFiManager.h>
#include "debug_serial.h"
#include "sensors/sensors.h"
#include <ESPAsyncWebServer.h>
#include <AsyncElegantOTA.h>
#include <WiFi.h>
#include <AsyncTCP.h>

#define EEPROM_SIZE 12
#define DONE_SET_VALUE 99

AsyncWebServer server(80);

static bool wifiRes;
//WiFiManager, Local intialization. Once its business is done, there is no need to keep it around
static WiFiManager wm;

// NOTE: Run "pio run -t erase" to erase flash memory 
static int readFlashChannelID( void );
static void startOTA( void );

void setup(void) 
{
  // Always disable relay during startup
  pinMode(RELAY_PIN, OUTPUT);
  digitalWrite(RELAY_PIN, LOW);

  // Initialize TFT dispaly
  initTFT();

  // Initiialize Serial Communication UART 0
  Serial.begin(115200);

  EEPROM.begin(EEPROM_SIZE);
  
  // NOTE: reset settings - wipe stored credentials for testing
  //wm.resetSettings();

  DEBUG_PRINT_LN("Starting to Connect");
  displaySetupConnectToWifi();
  wifiRes = wm.autoConnect("HomeSecurity Setup","password"); // password protected ap

  if(!wifiRes) 
  {
      displaySetupConnectToWifiFailed();
      delay(UI_SETUP_DELAY_TEXT);
      ESP.restart();
  } 
  else 
  {
      displaySetupConnectToWifiPassed();
      delay(UI_SETUP_DELAY_TEXT);

      // Start OTA webserver
      startOTA();
      displayOTAServer( WiFi.localIP().toString() );
      delay(UI_SETUP_DELAY_TEXT+2500);
      
      int setFlag = EEPROM.read( MAXIMUM_CHANNEL_ID_NUMBER );
      g_customerChannelID = readFlashChannelID();

      if ( ( DONE_SET_VALUE !=  setFlag ) )
      {
        while( UI_HOME_SECUIRTY_SETUP_DONE_SETUP != g_projectCurrentSetupState )
        {
          setupFlow();
        }
      }

    // Initialize Twillio 
    initTwilio();
  }

  bool successUpdate = false;
  
  displayThingspeakExtraction();
  delay(UI_SETUP_DELAY_TEXT);
  
  successUpdate = updateHomeOwnerInformation( g_customerChannelID );
  if( false == successUpdate )
  {
    EEPROM.write(MAXIMUM_CHANNEL_ID_NUMBER, 00);
    EEPROM.commit();
    ESP.restart();
  }
  
  displayThingspeakExtractionInformation();
  delay(UI_SETUP_DELAY_TEXT);
}

void loop() 
{
  dashboardFlow();
}

static int readFlashChannelID( void ) 
{
    int value = 0;
    for (int i = MAXIMUM_CHANNEL_ID_NUMBER -1; i >= 0; i--) {
    byte digit = EEPROM.read(i);
    value = value * 10 + digit;
    }
    return value;
}

static void startOTA( void )
{
    Serial.print("IP address: ");
    Serial.println(WiFi.localIP());

    server.on("/", HTTP_GET, [](AsyncWebServerRequest *request) {
      request->send(200, "text/plain", "Hi! This is a sample response.");
    });

    AsyncElegantOTA.begin(&server);    // Start AsyncElegantOTA
    server.begin();
    Serial.println("HTTP server started");
}
