stephennacion06/power-theft-detection/power-theft-detection/src/debug_serial.h

#ifndef DEBUG_SERIAL_H
#define DEBUG_SERIAL_H

#define DEBUG_ENABLED 0

#if 1  == DEBUG_ENABLED
#define DEBUG_PRINT(...)     Serial.print(__VA_ARGS__)
#define DEBUG_PRINT_LN(...)  Serial.println(__VA_ARGS__)
#else
#define DEBUG_PRINT(...)
#define DEBUG_PRINT_LN(...)
#endif

#endif // DEBUG_SERIAL_H
