stephennacion06/power-theft-detection/power-theft-detection/examples/voltage_sensor/voltage_sensor_calibate.cpp

#include <Arduino.h>
#include <ZMPT101B.h>
#include <Adafruit_I2CDevice.h>

#define ACTUAL_VOLTAGE 210.5f // Change this based on actual voltage

#define ESP32 1

#define START_VALUE 0.0f
#define STOP_VALUE 1000.0f
#define STEP_VALUE 0.25f
#define TOLLERANCE 1.0f // 2.90 accurate tolerance

#define MAX_TOLLERANCE_VOLTAGE (ACTUAL_VOLTAGE + TOLLERANCE)
#define MIN_TOLLERANCE_VOLTAGE (ACTUAL_VOLTAGE - TOLLERANCE)

// ZMPT101B sensor output connected to analog pin A0
// and the voltage source frequency is 50 Hz.
ZMPT101B voltageSensor(A4, 60.0);

void setup() {
  Serial.begin(9600);
  Serial.print("The Actual Voltage: ");
  Serial.println(ACTUAL_VOLTAGE);

  float senstivityValue = START_VALUE;
  voltageSensor.setSensitivity(senstivityValue);
  float voltageNow = voltageSensor.getRmsVoltage();

  Serial.println("Start calculate");

  while (voltageNow > MAX_TOLLERANCE_VOLTAGE || voltageNow < MIN_TOLLERANCE_VOLTAGE) {
    if (senstivityValue < STOP_VALUE) {
      senstivityValue += STEP_VALUE;
      voltageSensor.setSensitivity(senstivityValue);
      voltageNow = voltageSensor.getRmsVoltage();
      Serial.print(senstivityValue);
      Serial.print(" => ");
      Serial.println(voltageNow);
    } else {
      Serial.println("Unfortunately the sensitivity value cannot be determined");
      return;
    }
  }

  Serial.print("Closest voltage within tolerance: ");
  Serial.println(voltageNow);
  Serial.print("Sensitivity Value: ");
  Serial.println(senstivityValue, 10);
}

void loop() {}
