stephennacion06/power-theft-detection/power-theft-detection/src/tft_display/ui_display.h

#ifndef UI_DISPLAY_H
#define UI_DISPLAY_H

#define validNumber 7
#define validNumberMin pow(10, validNumber - 1)
#define validNumberMax pow(10, validNumber) - 1

#define  UI_SETUP_DELAY_TEXT 2500 

#define DASHBOARD_LOOP_PERIOD 1000 // Display updates every 1 second

#define THINGSPEAK_TRANSMIT_INTERVAL 30000 // Transmist every 30 seconds

#define DASHBOARD_STATUS_LOOP_PERIOD 50 // Display updates every 1 second

#include "FS.h"
#include "state_machine/statemachine.h"
#include <SPI.h>
#include <TFT_eSPI.h>      // Hardware-specific library



// This is the file name used to store the calibration data
// You can change this to create new calibration files.
// The SPIFFS file name must start with "/".
#define CALIBRATION_FILE "/TouchCalData1"

// Set REPEAT_CAL to true instead of false to run calibration
// again, otherwise it will only be done once.
// Repeat calibration if you change the screen rotation.
#define REPEAT_CAL false

// Keypad start position, key sizes and spacing
#define KEY_X 40 // Centre of key
#define KEY_Y 96
#define KEY_W 62 // Width and height
#define KEY_H 30
#define KEY_SPACING_X 18 // X and Y gap
#define KEY_SPACING_Y 20
#define KEY_TEXTSIZE 1   // Font size multiplier

// Using two fonts since numbers are nice when bold
#define LABEL1_FONT &FreeSansOblique12pt7b // Key label font 1
#define LABEL2_FONT &FreeSansBold12pt7b    // Key label font 2

// Numeric display box size and location
#define DISP_X 1
#define DISP_Y 10
#define DISP_W 238
#define DISP_H 50
#define DISP_TSIZE 3
#define DISP_TCOLOR TFT_CYAN

// We have a status line for messages
#define STATUS_X 120 // Centred on this
#define STATUS_Y 65

// Function declaration
void initTFT( void );
void displaySetupTextInsertChannelID( void );
void displaySetupText( void );
void touch_calibrate( void );
void uiSetupDisplayDrawKeypad( void );
void uiSetupDisplayKeypadLoop( void );
void displaySetupConnectToWifi( void );
void displaySetupConnectToWifiFailed( void );
void displaySetupConnectToWifiPassed( void );
void displayThingspeakExtraction( void );
void displayThingspeakExtractionInformation( void );
void saveToFlashChannelID(int value);
void displayOTAServer( String ipAddress );

//Dashboard Public Function
void dashboardSetup( void );
int dashboardLoop( void );
int dashboardPowerTheftDisplay( void );
void dashBoardPowerTheftDetectedSetup( void );

#endif  // UI_DISPLAY_H
