stephennacion06/power-theft-detection/power-theft-detection/examples/thingspeak/secrets.h

// Use this file to store all of the private credentials 
// and connection details

#define SECRET_SSID "ICE_PLDT_WIFI"		// replace MySSID with your WiFi network name
#define SECRET_PASS "ice12345"	// replace MyPassword with your WiFi password

#define SECRET_CH_ID 2196228			// replace 0000000 with your channel number
#define SECRET_WRITE_APIKEY "YSJUIYOUWFNDC9WV"   // replace XYZ with your channel write API Key
