stephennacion06/power-theft-detection/(commit log)

2023-06-07 update latest documents
    [bill_of_materials.xlsx]
2023-06-18 added currrent sensor and voltage sensor
2023-06-23 added example for fire, motion and door sensor
2023-06-23 updated wiring diagram added colors and amplifier
2023-06-27 Updated wiring diagram
2023-07-17 initial 3d files
    [16Bit I2C ADC+PGA - ADS1115.stp, 19-Pin Header - Female - 2.54mm.step, Hi-link 5v rectifier module.stp, egizmo_universal_pcb.SLDPRT, esp32shield.SLDPRT, pcb_screw_terminal_block_15pins.step, pcb_screw_terminal_block_2_pins.STEP, pcb_screw_terminal_block_4pins.step]
2023-07-19 final 3d components
    [10-Pin Header - Female - 2.54mm.step, 1pins.step, 2pins.step, 3pinheader_male.SLDASM, 8pins.step, BNH15LW_converted.SLDPRT, DIN Rail, Aluminum, 35 mm Wide, 7 mm Height, 4 mm Wide and 8 mm Length Slots, 100 mm Length.SLDPRT, Flame Sensor.SLDPRT]
2023-07-22 latest 3d files
    [BNH15LW_converted.SLDPRT, Chassis Cover.SLDPRT, Cover Main.STL, DIN Rail, Aluminum, 35 mm Wide, 7 mm Height, 4 mm Wide and 8 mm Length Slots, 100 mm Length.SLDPRT, Main Chassis.SLDPRT, Main Chassis.STL]
2023-07-22 added debug serial. Change motion sensor pin to pin 15
2023-07-23 Updated relay pin. Updated touch interval checking
2023-07-25 Center text and prevent from stuck if invalid channel id
    [main.cpp, ui_display.cpp]
